drzwave/ZRAD/hardware/ZRADmini/ZRADmini.kicad_pcb

## KiCad design hardware/ZRADmini/ZRADmini.kicad_pcb (2025-01-03)

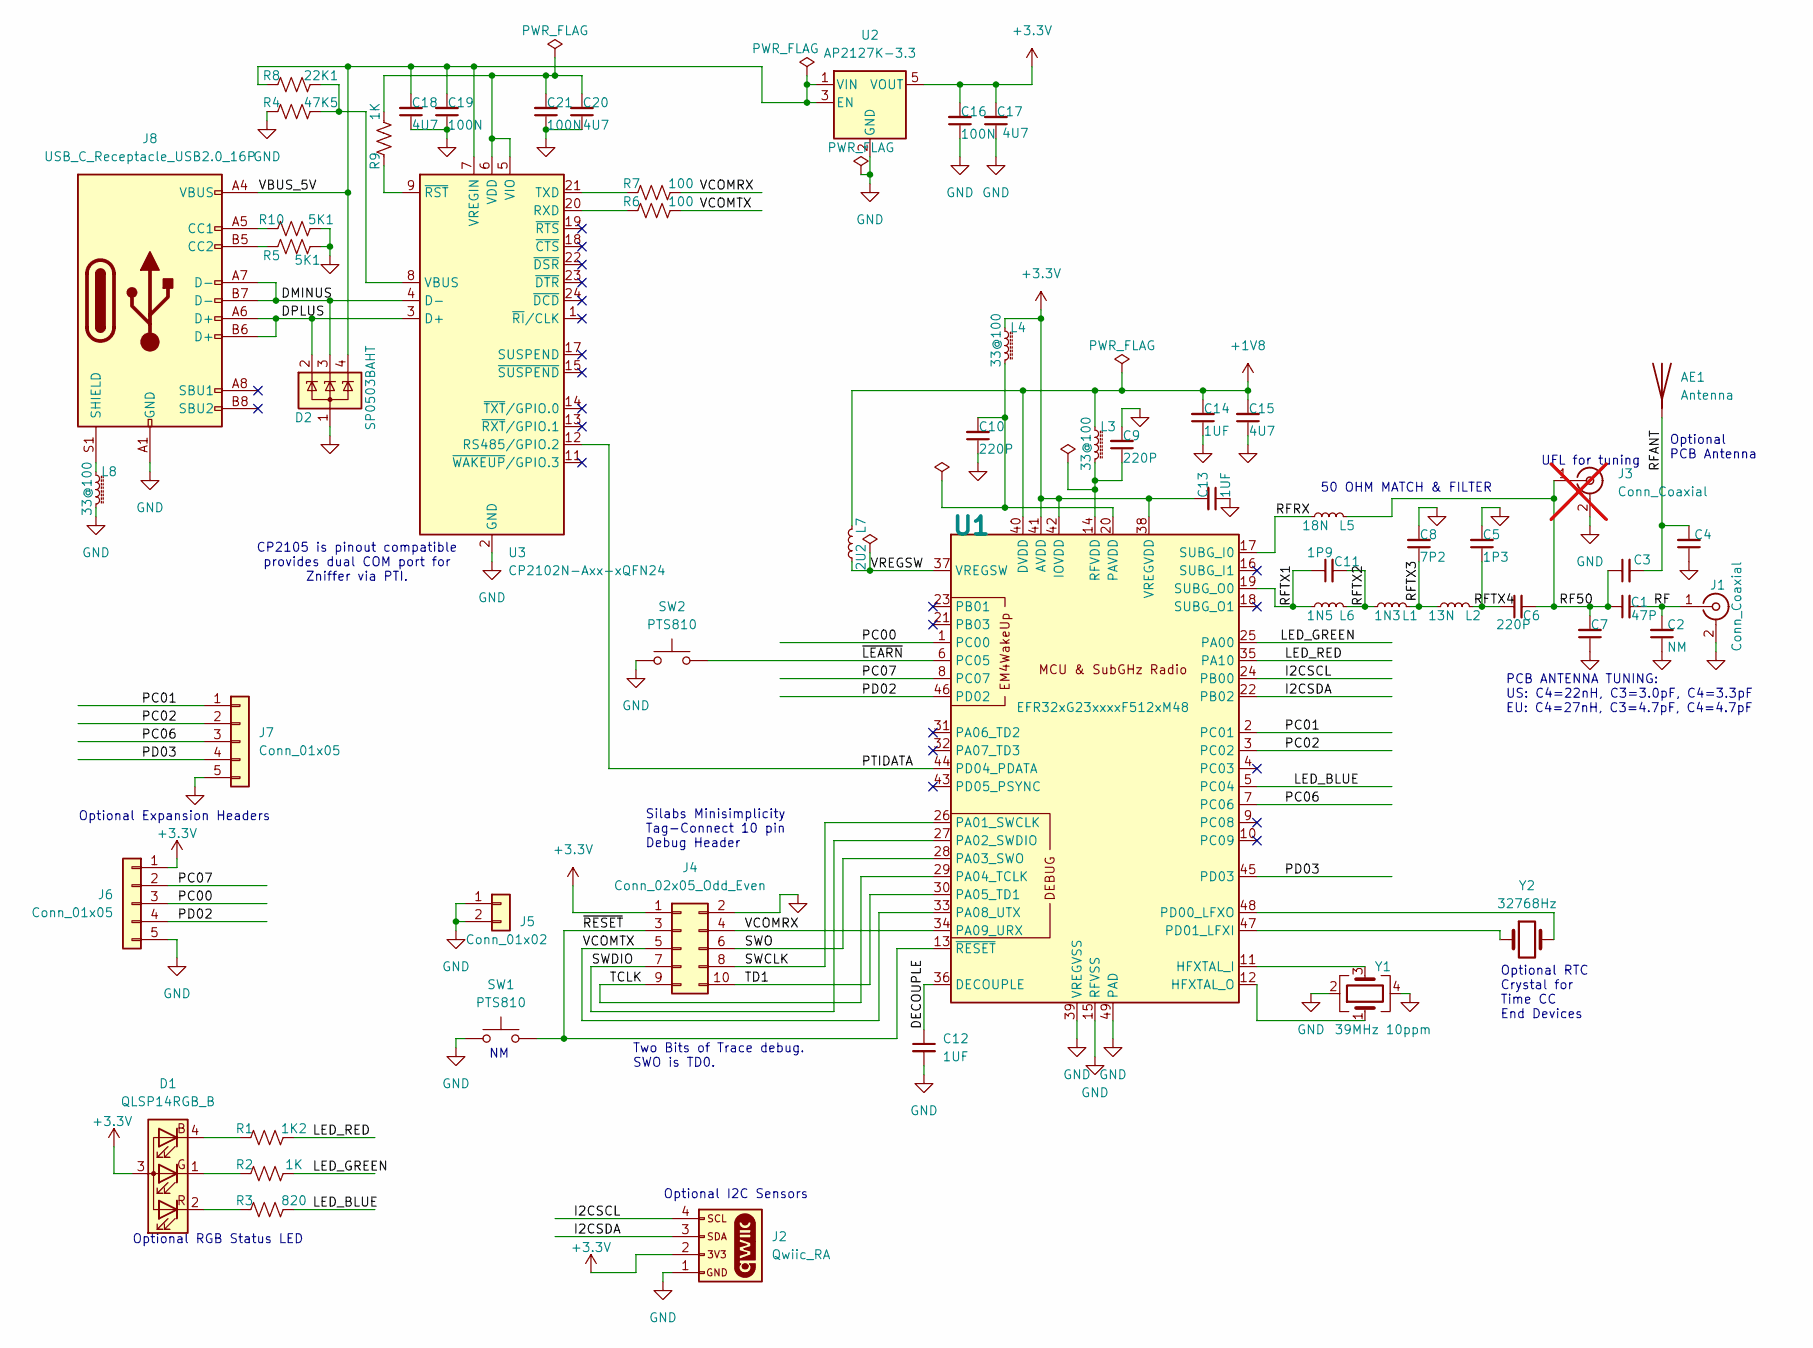
[picture p3: schematic ZRADmini.kicad_sch, ZRAD Mini Z-Wave Reference Application Design]

Parts:
AE1: Antenna; PCB_meander_20mm_900MHz
C1, C3: 47P; C_0402_1005Metric
C2, C4, C7: NM; C_0402_1005Metric
C5: 1P3; C_0402_1005Metric
C6, C9, C10: 220P; C_0402_1005Metric
C8: 7P2; C_0402_1005Metric
C11: 1P9; C_0402_1005Metric
C12, C13, C14: 1UF; C_0603_1608Metric
C15, C17, C18, C20: 4U7; C_0805_2012Metric
C16, C19, C21: 100N; C_0603_1608Metric
D1: QLSP14RGB_B; LED_QLSP14RGB
D2: SP0503BAHT; SOT-143
J1: Conn_Coaxial; SMA_Wurth_60312002114503_Vertical
J2: Qwiic_RA; JST_SH_SM04B-SRSS-TB_1x04-1MP_P1.00mm_Horizontal
J3: Conn_Coaxial; U.FL_Hirose_U.FL-R-SMT-1_Vertical; not fitted
J4: Conn_02x05_Odd_Even; Tag-Connect_TC2050-IDC-NL_2x05_P1.27mm_Vertical
J5: Conn_01x02; PinHeader_1x02_P2.54mm_Vertical
J6, J7: Conn_01x05; PinHeader_1x05_P2.54mm_Vertical
J8: USB_C_Receptacle_USB2.0_16P; USB_C_Receptacle_GCT_USB4110
L1: 1N3; L_0402_1005Metric
L2: 13N; L_0402_1005Metric
L3, L4, L8: 33@100; L_0603_1608Metric
L5: 18N; L_0402_1005Metric
L6: 1N5; L_0402_1005Metric
L7: 2U2; L_0603_1608Metric
R1: 1K2; R_0603_1608Metric
R2, R9: 1K; R_0603_1608Metric
R3: 820; R_0603_1608Metric
R4: 47K5; R_0603_1608Metric
R5, R10: 5K1; R_0603_1608Metric
R6, R7: 100; R_0603_1608Metric
R8: 22K1; R_0603_1608Metric
SW1, SW2: PTS810; SW_SPST_PTS810
U1: EFR32xG23xxxxF512xM48; QFN-48-1EP_6x6mm_P0.4mm_EP4.3x4.3mm
U2: AP2127K-3.3; SOT-23-5
U3: CP2102N-Axx-xQFN24; QFN-24-1EP_4x4mm_P0.5mm_EP2.6x2.6mm
Y1: 39MHz 10ppm; Crystal_SMD_3225-4Pin_3.2x2.5mm
Y2: 32768Hz; Crystal_SMD_3215-2Pin_3.2x1.5mm

Connections:
+1V8: C14.2, C15.2, L3.1, L7.2, U1.40 (DVDD)
+3.3V: C13.2, C16.2, C17.2, D1.3 (A), J2.2, J4.1, J6.1, L4.1, U1.38 (VREGVDD), U1.41 (AVDD), U1.42 (IOVDD), U2.5 (VOUT)
/DECOUPLE: C12.1, U1.36 (DECOUPLE)
/DMINUS: D2.3 (K), J8.A7 (D-), J8.B7 (D-), U3.4 (D-)
/DPLUS: D2.2 (K), J8.A6 (D+), J8.B6 (D+), U3.3 (D+)
/I2CSCL: J2.4, U1.24 (PB00)
/I2CSDA: J2.3, U1.22 (PB02)
/LED_BLUE: R3.2, U1.5 (PC04)
/LED_GREEN: R2.2, U1.25 (PA00)
/LED_RED: R1.2, U1.35 (PA10)
/PC00: J6.3, U1.1 (PC00)
/PC01: J7.1, U1.2 (PC01)
/PC02: J7.2, U1.3 (PC02)
/PC06: J7.3, U1.7 (PC06)
/PC07: J6.2, U1.8 (PC07)
/PD02: J6.4, U1.46 (PD02)
/PD03: J7.4, U1.45 (PD03)
/PTIDATA: U1.44 (PD04_PDATA), U3.12 (RS485/GPIO.2)
/RF: C1.2, C2.2, J1.1 (In)
/RF50: C1.1, C3.1, C6.2, C7.2, J3.1 (In), L5.2
/RFANT: AE1.1 (A), C3.2, C4.2
/RFRX: L5.1, U1.17 (SUBG_I0)
/RFTX1: C11.1, L6.1, U1.19 (SUBG_O0)
/RFTX2: C11.2, L1.1, L6.2
/RFTX3: C8.1, L1.2, L2.1
/RFTX4: C5.1, C6.1, L2.2
/SWCLK: J4.8, U1.26 (PA01_SWCLK)
/SWDIO: J4.7, U1.27 (PA02_SWDIO)
/SWO: J4.6, U1.28 (PA03_SWO)
/TCLK: J4.9, U1.29 (PA04_TCLK)
/TD1: J4.10, U1.30 (PA05_TD1)
/VBUS_5V: C18.2, C19.2, D2.4 (K), J8.A4 (VBUS), J8.A9 (VBUS), J8.B4 (VBUS), J8.B9 (VBUS), R8.1, U2.1 (VIN), U2.3 (EN), U3.7 (VREGIN)
/VCOMRX: J4.4, R7.2, U1.34 (PA09_URX)
/VCOMTX: J4.5, R6.2, U1.33 (PA08_UTX)
/VREGSW: L7.1, U1.37 (VREGSW)
/~LEARN: SW2.2, U1.6 (PC05)
/~RESET: J4.3, SW1.2, U1.13 (~RESET)
GND: C2.1, C4.1, C5.2, C7.1, C8.2, C9.2, C10.1, C12.2, C13.1, C14.1, C15.1, C16.1, C17.1, C18.1, C19.1, C20.1, C21.1, D2.1 (A), J1.2 (Ext), J2.1, J3.2 (Ext), J4.2, J5.1, J5.2, J6.5, J7.5, J8.A1 (GND), J8.A12 (GND), J8.B1 (GND), J8.B12 (GND), L8.2, R4.1, R5.2, R10.2, SW1.1, SW2.1, U1.15 (RFVSS), U1.39 (VREGVSS), U1.49 (PAD), U2.2 (GND), U3.2 (GND), U3.25 (GND), Y1.2, Y1.4
unnamed: D1.4 (BK), R1.1
unnamed: D1.1 (GK), R2.1
unnamed: D1.2 (RK), R3.1
unnamed: J8.A5 (CC1), R10.1
unnamed: J8.B5 (CC2), R5.1
unnamed: J8.S1 (SHIELD), L8.1
unnamed: U1.11 (HFXTAL_I), Y1.3
unnamed: U1.12 (HFXTAL_O), Y1.1
unnamed: C10.2, L4.2, U1.20 (PAVDD)
unnamed: U1.48 (PD00_LFXO), Y2.2
unnamed: U1.47 (PD01_LFXI), Y2.1
unnamed: C9.1, L3.2, U1.14 (RFVDD)
unnamed: R6.1, U3.20 (RXD)
unnamed: R7.1, U3.21 (TXD)
unnamed: R4.2, R8.2, U3.8 (VBUS)
unnamed: C20.2, C21.2, R9.2, U3.5 (VIO), U3.6 (VDD)
unnamed: R9.1, U3.9 (~RST)

Notes on the sheet:
CP2105 is pinout compatible provides dual COM port for Zniffer via PTI.
Two Bits of Trace debug. SWO is TD0.
50 OHM MATCH & FILTER
UFL for tuning
Optional Expansion Headers
Optional PCB Antenna
Optional RGB Status LED
Silabs Minisimplicity Tag-Connect 10 pin Debug Header
PCB ANTENNA TUNING: US: C4=22nH, C3=3.0pF, C4=3.3pF EU: C4=27nH, C3=4.7pF, C4=4.7pF
Optional I2C Sensors
Optional RTC Crystal for Time CC End Devices

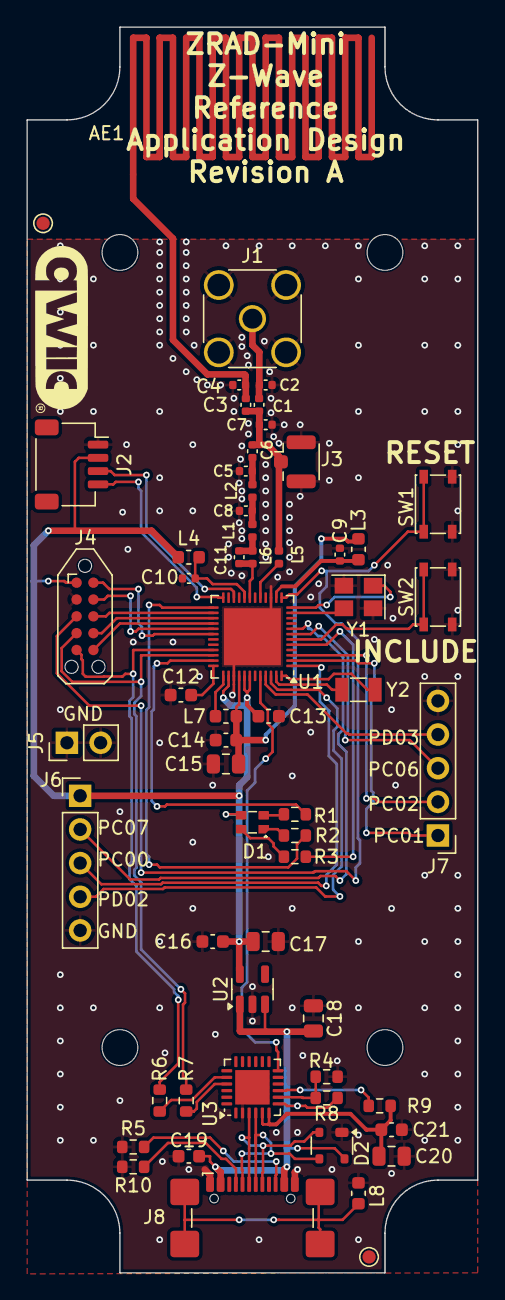
[picture p4: board ZRADmini.kicad_pcb from above]

Board: 2 copper layers, 34.0 x 94.0 mm, 65 parts (1 on the bottom side), 55 nets.

Other parts of the board:
FUD1, FUD2: TestPoint_Pad_D1.0mm
NE: MountingHole_2.7mm
NW: MountingHole_2.7mm
QWIICLOGO: LOGO; QWIIC
SE: MountingHole_2.7mm
SW: MountingHole_2.7mm
ZWA: LOGO; ZWA_Logo
